ExploreEmbedded/oneMicro-ATmega128/Others/BOM/oneMicro ATmega128.xls

 | oneMicro ATmega128 |  | 10
Id | Designator | Package | Units | Designation | Quantity
2 | J2 | 40X1 Through hole | 0.25 | Male Pin Headers | 2.5
3 | P3,P4,P2,P1 | 40X1 Through hole | 1 | Male Pin Headers | 10
4 | P8 | 40X2 Through hole | 0.125 | Male Pin Headers | 1.25
5 | X1 | Through hole | 1 | 16Mhz Crystal | 10
6 | C1,C2 | 0603 SMD | 2 | 22PF | 20
7 | C3,C4,C6,C7,C8 | 0603 SMD | 5 | 0.1uF | 50
8 | D1,D3 | 0603 SMD | 2 | LED | 20
9 | IC1 | TQPF | 1 | ATMEGA128-A | 10
11 | R1 | 0603 SMD | 1 | 10K | 10
12 | R2,R3,R5,R4 | 0603 SMD | 4 | 470E | 40
13 | SW1 | Through hole | 1 | 2 Pin Tactile s/w | 10
14 | CON1 | SMD | 1 | Micro USB | 10
15 | U1 | QFN | 1 | CP2102 | 10
