ExploreEmbedded/oneMicro-ATmega128/Design Files/Schematic/oneMicro ATmega128_Schematic.pdf

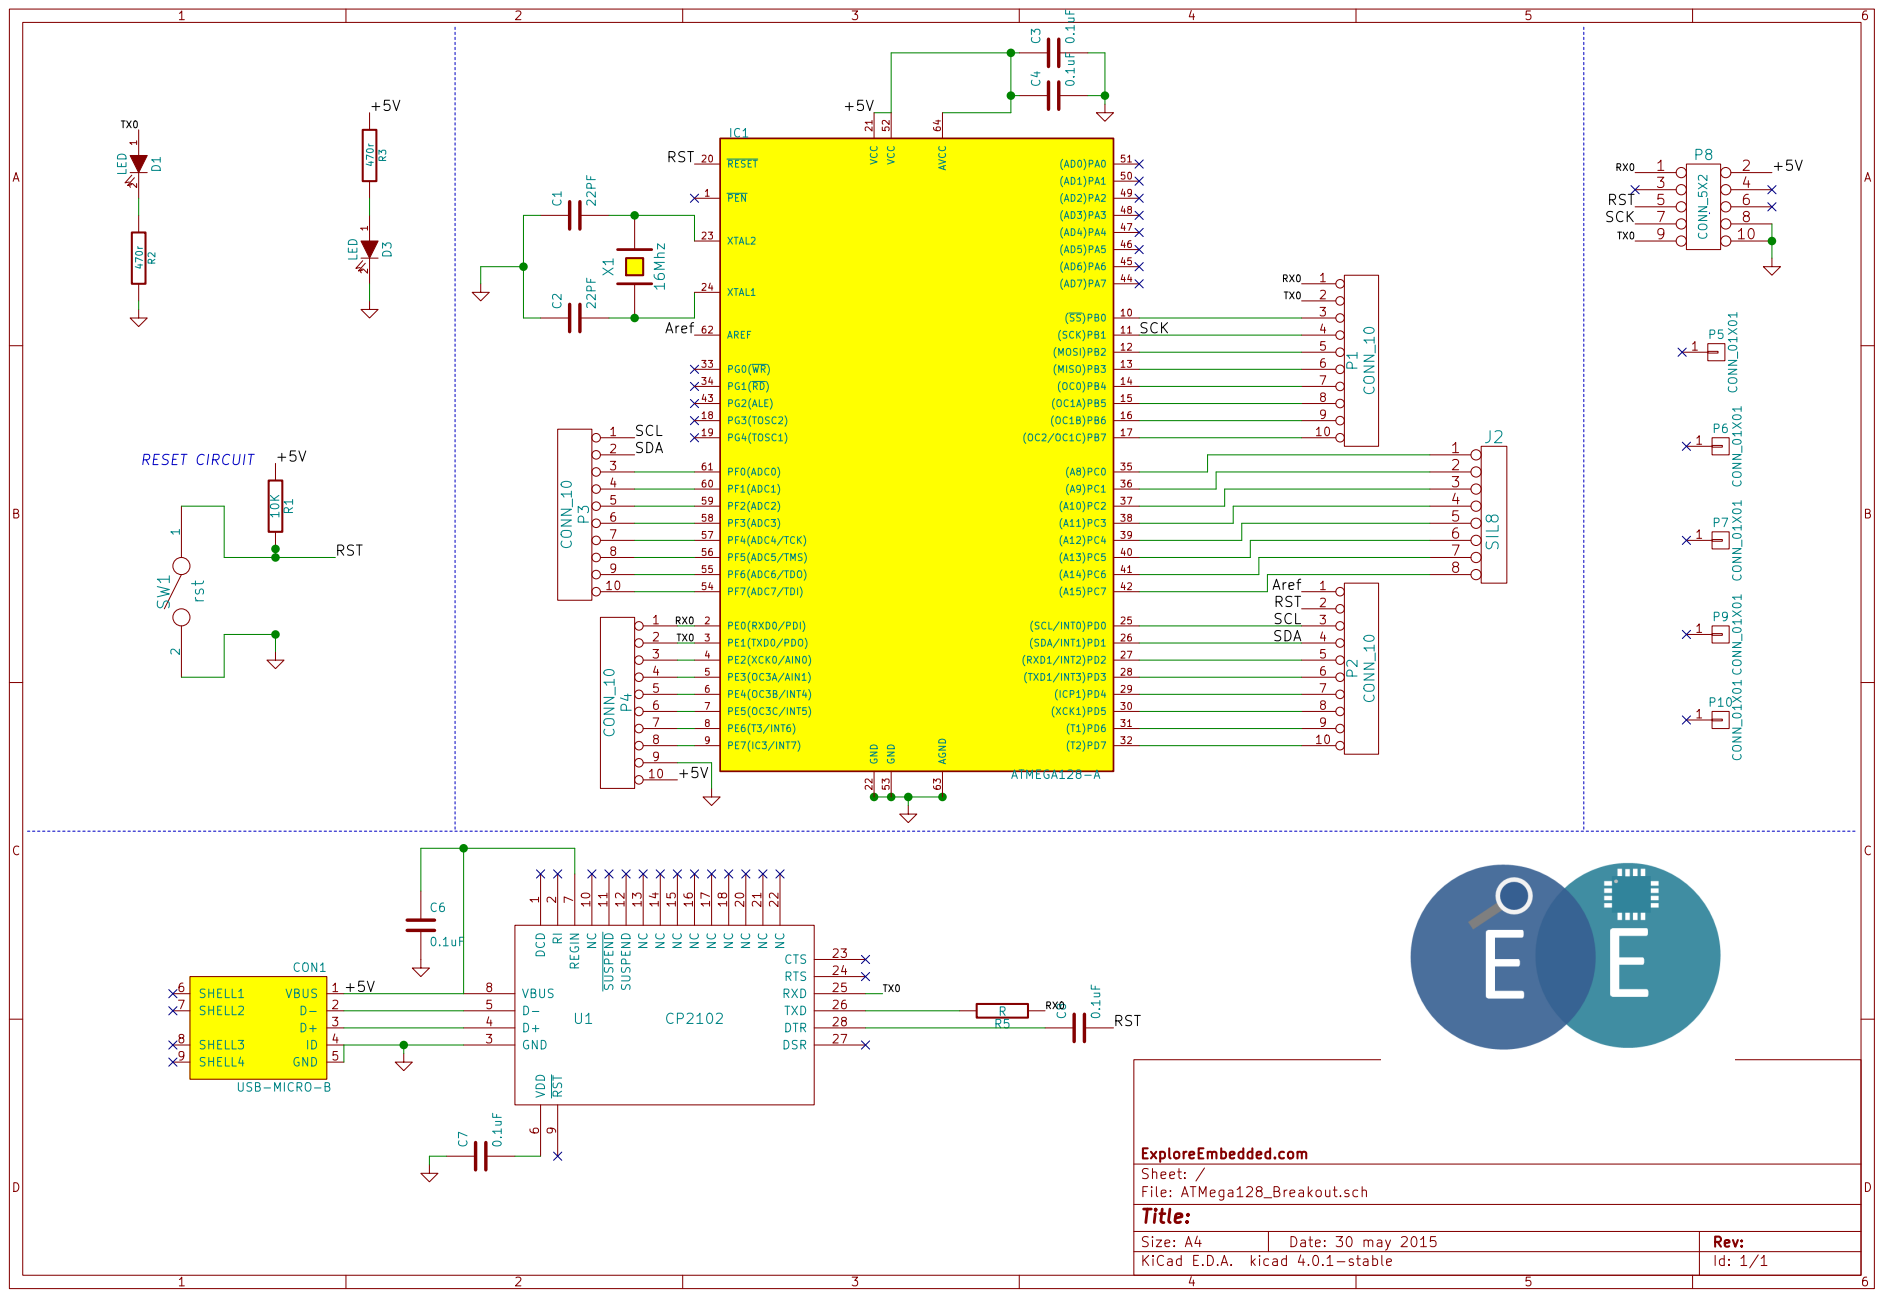
[picture p1: page 1]
