ExploreEmbedded/oneMicro-ATmega128/Code Library/Sample Code atmega128/ADC/Multi_Channel/Multi_Channel/Multi_Channel.c

/***************************************************************************************************
                                   ExploreEmbedded	
****************************************************************************************************
 * File:   main.c
 * Version: 15.0
 * Author: ExploreEmbedded
 * Website: http://www.exploreembedded.com/wiki
 * Description: Program to demonstrate multi(4) channel ADC,10bit(0-1023) adc value is displayed on lcd
 
The libraries have been tested on ExploreEmbedded development boards. We strongly believe that the 
library works on any of development boards for respective controllers. However, ExploreEmbedded 
disclaims any kind of hardware failure resulting out of usage of libraries, directly or indirectly.
Files may be subject to change without prior notice. The revision history contains the information 
related to updates. 
 
 
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
Errors and omissions should be reported to codelibraries@exploreembedded.com
 **************************************************************************************************/


/* Reg51.h contains the defnition of all ports and SFRs */


#include "lcd.h"	//User defined LCD library which conatins the lcd routines
#include "adc.h"   //User defined library which conatins the adc routines


/* start the main program */
void main() 
{
   uint16_t adc_result0,adc_result1,adc_result2,adc_result3;		

    LCD_Init(4,2,16);	   /* Initialize 2x16lcd in 8-bit mode */    
    ADC_Init();			   /* Initialize the adc module*/	 
    
   while(1)
    {
       	/* Get the adc value of first four channels */
		 adc_result0= ADC_GetAdcValue(0);
		 adc_result1= ADC_GetAdcValue(1);
		 adc_result2= ADC_GetAdcValue(2);
		 adc_result3= ADC_GetAdcValue(3);		  
	
		 LCD_GoToLine(1);
         LCD_Printf("C0:%d C1:%d \nC2:%d C3:%d ",adc_result0,adc_result1,adc_result2,adc_result3);         	     
    }			 
}
