ExploreEmbedded/oneMicro-ATmega128/Code Library/Sample Code atmega128/ADC/Single_Channel/Single_Channel/Single_Channel.c

/*-----------------------------------------------------------------------------
 Program to demonstrate single channel ADC, 10bit(0-1023) adc value is displayed on lcd
  -----------------------------------------------------------------------------
  note:
  1.Refer lcd.c(lcd_4_bit.c/lcd_8_bit.c) file for Pin connections
  2.Refer Atmega32 datasheet for register description.
------------------------------------------------------------------------------*/



#include "lcd.h"	//User defined LCD library which conatins the lcd routines
#include "adc.h"   //User defined library which conatins the adc routines


/* start the main program */
void main() 
{
   uint16_t adc_result;

  /* Initialize the lcd before displaying any thing on the lcd */
    LCD_Init(4,2,16);

  /* Initialize the adc before starting the conversion */
    ADC_Init();

  /* Display "ADC Channel zero" on first line*/
  LCD_Printf("ADC Channel zero");

   /* Display the adc channel zero value continously */ 
   while(1)
    {
	     /*Get the adc value of channel zero */
		 adc_result= ADC_GetAdcValue(0);

        /*Go to second line and display the adc value */
         LCD_GoToLine(2);
        LCD_Printf("%u",adc_result);
		 
      }


  }
