ExploreEmbedded/oneMicro-ATmega128/(commit log)

2016-07-28 Added Design Files
    [ATMega128_Breakout.kicad_pcb, ATMega128_Breakout.sch]
2016-07-29 Updated Designs
    [ATMega128_Breakout.kicad_pcb, ATMega128_Breakout.sch]
2016-07-30 added name oneMicro to the board series
    [ATMega128_Breakout.kicad_pcb]
2016-07-30 minor change
    [ATMega128_Breakout.kicad_pcb]
2016-08-23 Schematic PDF file generated
2016-08-29 BOM generated
    [oneMicro ATmega128.xls]
2016-09-14 Changed legend
    [ATMega128_Breakout.kicad_pcb]
2016-09-26 Folder structure
    [ATMega128_Breakout.kicad_pcb, ATMega128_Breakout.sch, oneMicro ATmega128.xls]
2016-09-26 Changed switch and crystal to smd and legends
    [ATMega128_Breakout.kicad_pcb, ATMega128_Breakout.sch]
2016-10-01 Gerber File generated
    [ATMega128_Breakout-B_Cu.gbr, ATMega128_Breakout-B_Mask.gbr, ATMega128_Breakout-B_SilkS.gbr, ATMega128_Breakout-F_Cu.gbr, ATMega128_Breakout-F_Mask.gbr, ATMega128_Breakout-F_SilkS.gbr, ATMega128_Breakout.drl]
